Hyzie/IOT_RF/ChipDesign/Schematic.jpg

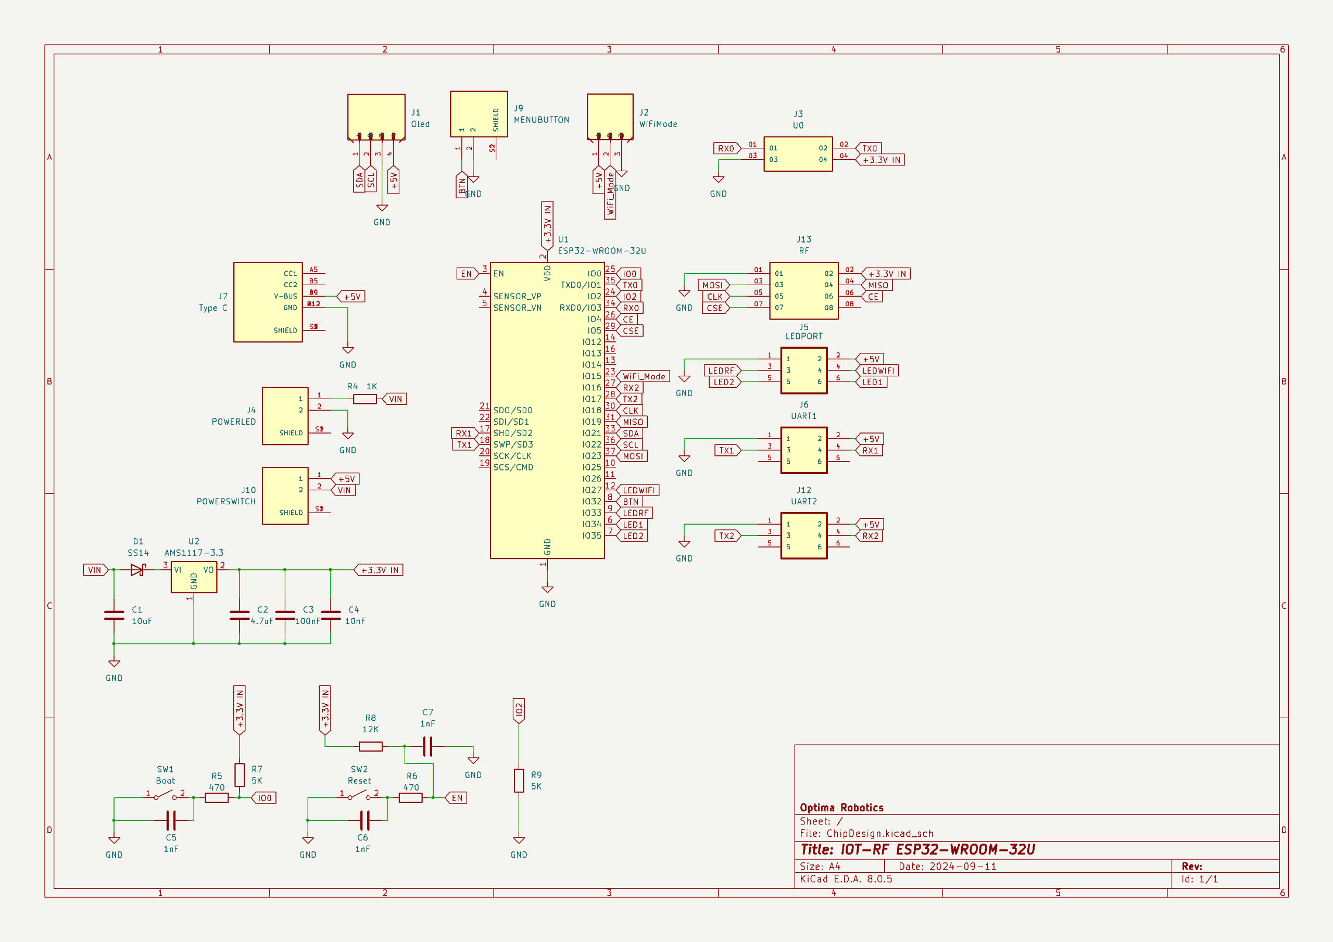
ChipDesign/Schematic.jpg
