Hyzie/IOT_RF/ChipDesign/ChipDesign.step

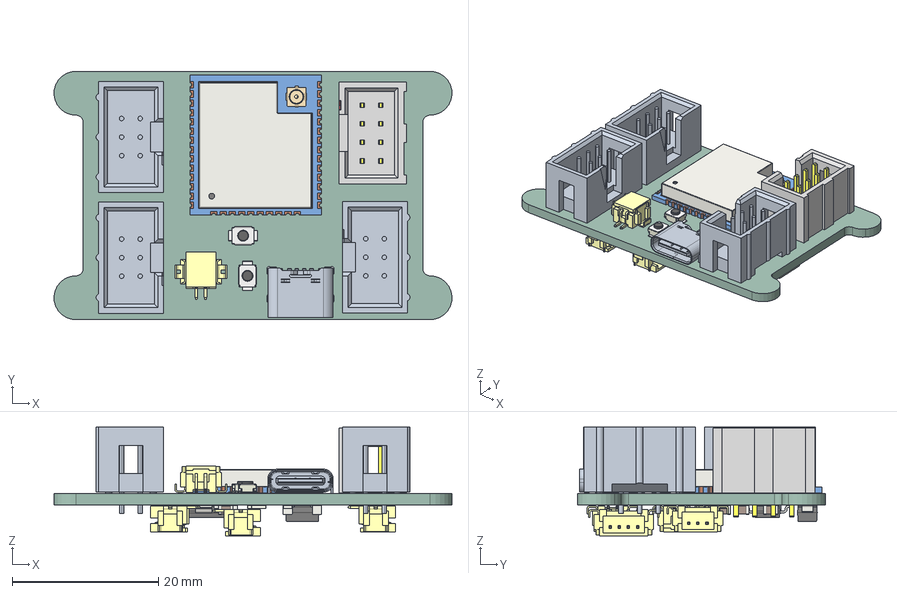
[picture p7: CAD file, 2024-09-18]
ChipDesign/ChipDesign.step
54.5 x 34.0 x 14.9 mm
SW_SPST_B3U-1000P x 2
ESP32-WROOM-32U
TSS-104-01-G-D
DF13A-2P-1.25HÈª x 3
UJC-HP-3-SMT-TR
R_0805_2012Metric x 6
C_0805_2012Metric x 7
D_SMA
SOT_223
DF13A-4P-1.25HÈª
DF13A-3P-1.25HÈª
ChipDesign_PCB
