Hyzie/IOT_RF/ChipDesign/ChipDesign.kicad_pcb

## KiCad design ChipDesign/ChipDesign.kicad_pcb (2024-09-18)

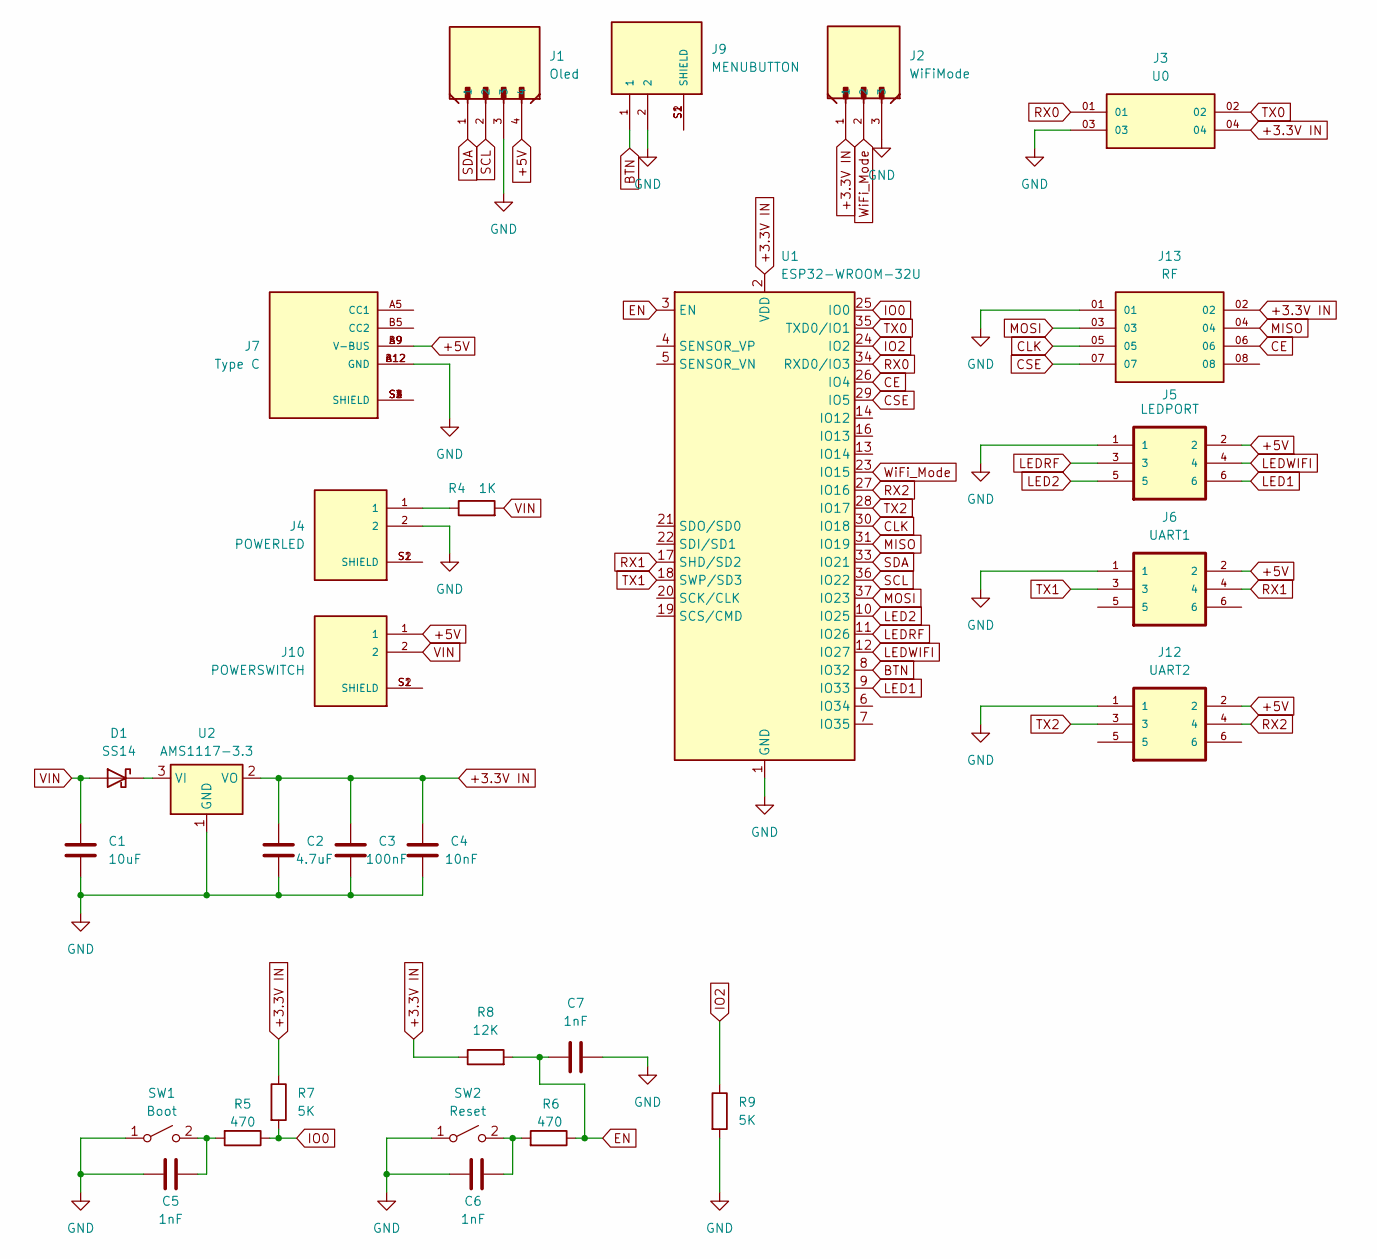
[picture p8: schematic ChipDesign.kicad_sch, IOT-RF ESP32-WROOM-32U]

Parts:
C1: 10uF; C_0805_2012Metric_Pad1.18x1.45mm_HandSolder
C2: 4.7uF; C_0805_2012Metric_Pad1.18x1.45mm_HandSolder
C3: 100nF; C_0805_2012Metric_Pad1.18x1.45mm_HandSolder
C4: 10nF; C_0805_2012Metric_Pad1.18x1.45mm_HandSolder
C5, C6, C7: 1nF; C_0805_2012Metric_Pad1.18x1.45mm_HandSolder
D1: SS14; D_SMA
J1: Oled; HRS_DF13A-4P-1.25H_21_
J2: WiFiMode; HRS_DF13A-3P-1.25H_21_
J3: U0; SAMTEC_RSM-102-02-S-D; PARTREV D
J4: POWERLED; HRS_DF13A-2P-1.25H_51_; PARTREV March 2020
J5: LEDPORT; TE_2-1761603-1; PARTREV B1
J6: UART1; TE_2-1761603-1; PARTREV B1
J7: Type C; CUI_UJC-HP-3-SMT-TR; PARTREV 04/30/2020
J9: MENUBUTTON; HRS_DF13A-2P-1.25H_51_; PARTREV March 2020
J10: POWERSWITCH; HRS_DF13A-2P-1.25H_51_; PARTREV March 2020
J12: UART2; TE_2-1761603-1; PARTREV B1
J13: RF; SAMTEC_TSS-104-01-G-D; PARTREV R
R4: 1K; R_0805_2012Metric_Pad1.20x1.40mm_HandSolder
R5, R6: 470; R_0805_2012Metric_Pad1.20x1.40mm_HandSolder
R7: 5K; R_0805_2012Metric_Pad1.20x1.40mm_HandSolder
R8: 12K; R_0805_2012Metric_Pad1.20x1.40mm_HandSolder
R9: 5K; R_0805_2012Metric
SW1: Boot; SW_Push_SPST_NO_Alps_SKRK
SW2: Reset; SW_Push_SPST_NO_Alps_SKRK
U1: ESP32-WROOM-32U
U2: AMS1117-3.3; SOT-223-3_TabPin2

Connections:
+3.3V IN: C2.1, C3.1, C4.1, J2.1, J3.04, J13.02, R7.1, R8.1, U1.2 (VDD), U2.2 (VO)
+5V: J1.4, J5.2, J6.2, J7.A9 (V-BUS), J7.B9 (V-BUS), J10.1, J12.2
BTN: J9.1, U1.8 (IO32)
CE: J13.06, U1.26 (IO4)
CLK: J13.05, U1.30 (IO18)
CSE: J13.07, U1.29 (IO5)
EN: C7.1, R6.1, R8.2, U1.3 (EN)
GND: C1.2, C2.2, C3.2, C4.2, C5.2, C6.2, C7.2, J1.3, J2.3, J3.03, J4.2, J5.1, J6.1, J7.A12 (GND), J7.B12 (GND), J9.2, J12.1, J13.01, R9.2, SW1.1 (A), SW2.1 (A), U1.1 (GND), U1.15 (GND), U1.38 (GND), U1.39 (GND), U2.1 (GND)
IO0: R5.1, R7.2, U1.25 (IO0)
IO2: R9.1, U1.24 (IO2)
LED1: J5.6, U1.9 (IO33)
LED2: J5.5, U1.10 (IO25)
LEDRF: J5.3, U1.11 (IO26)
LEDWIFI: J5.4, U1.12 (IO27)
MISO: J13.04, U1.31 (IO19)
MOSI: J13.03, U1.37 (IO23)
unnamed: D1.1 (K), U2.3 (VI)
unnamed: J4.1, R4.1
unnamed: J4.S1 (SHIELD), J4.S2 (SHIELD)
unnamed: J7.S1 (SHIELD), J7.S2 (SHIELD), J7.S3 (SHIELD), J7.S4 (SHIELD)
unnamed: J9.S1 (SHIELD), J9.S2 (SHIELD)
unnamed: J10.S1 (SHIELD), J10.S2 (SHIELD)
unnamed: C5.1, R5.2, SW1.2 (B)
unnamed: C6.1, R6.2, SW2.2 (B)
RX0: J3.01, U1.34 (RXD0/IO3)
RX1: J6.4, U1.17 (SHD/SD2)
RX2: J12.4, U1.27 (IO16)
SCL: J1.2, U1.36 (IO22)
SDA: J1.1, U1.33 (IO21)
TX0: J3.02, U1.35 (TXD0/IO1)
TX1: J6.3, U1.18 (SWP/SD3)
TX2: J12.3, U1.28 (IO17)
VIN: C1.1, D1.2 (A), J10.2, R4.2
WiFi_Mode: J2.2, U1.23 (IO15)

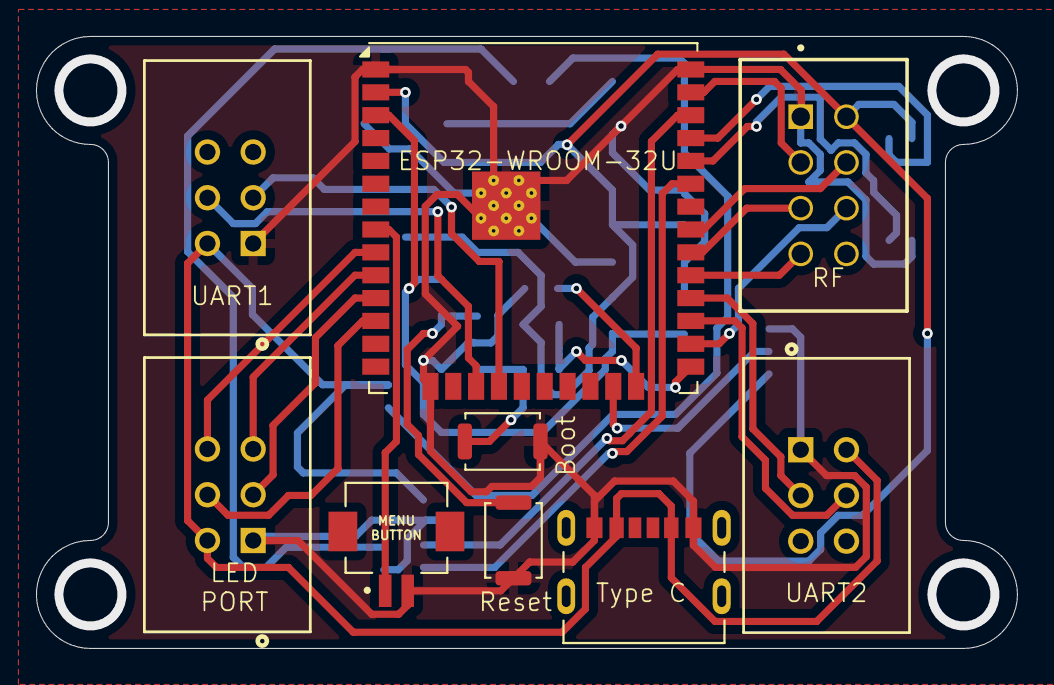
[picture p9: board ChipDesign.kicad_pcb from above]

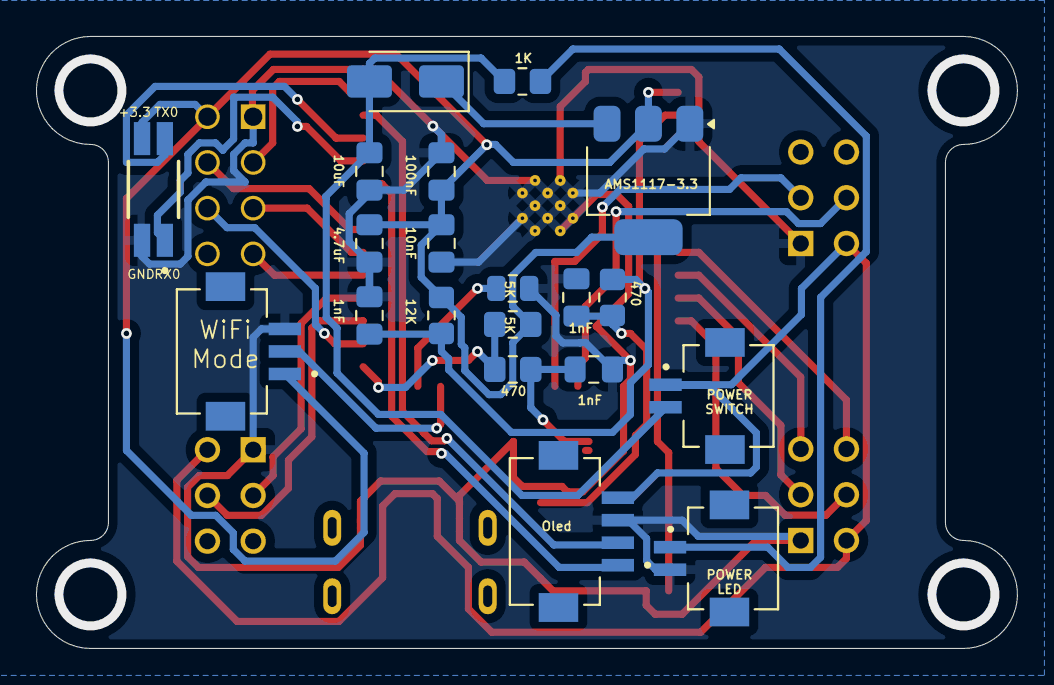
[picture p10: board ChipDesign.kicad_pcb from below]

Board: 2 copper layers, 54.5 x 34.0 mm, 29 parts (20 on the bottom side), 34 nets.
