Hyzie/IOT_RF/TestCode/TestRF/README.md

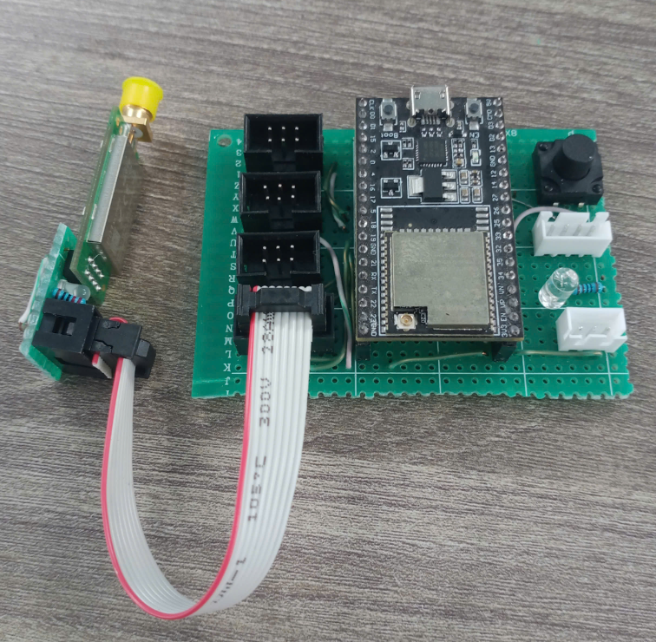
[picture p11: TestCode/TestRF/image.png]
# Bước 1: Nạp code TestTXesp.ino và TestRXesp.ino vào 2 module. Kết nối module RF vào cổng IDC8
# Bước 2: Mở terminal từ 2 module esp32 để quan sát.
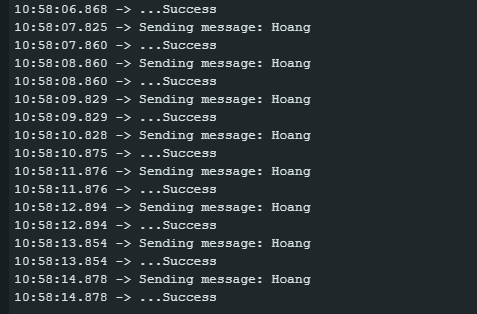
[picture p12: TestCode/TestRF/image-2.png]
## Module TX:
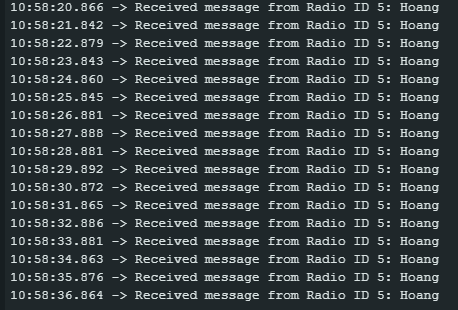
[picture p13: TestCode/TestRF/image-3.png]
## Module RX:
