Hyzie/IOT_RF/TestCode/TestUART/README.md

# Bước 1: Nạp code TestReadUART.ino và TestSendUART.ino cho các module esp32.
# Bước 2: Kết nối UART của 2 module lại với nhau(TX-RX, RX-TX, GND-GND).
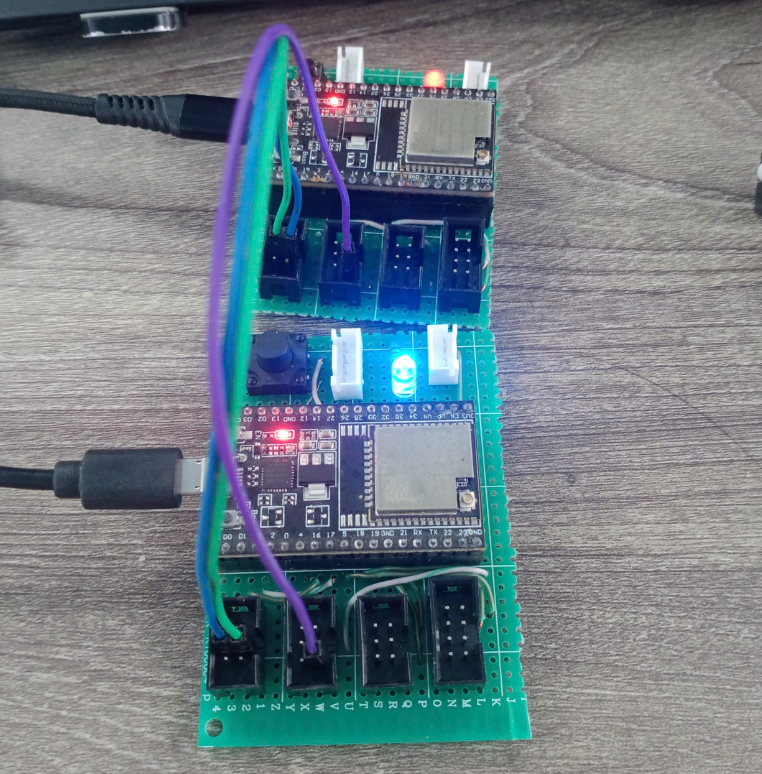
[picture p14: TestCode/TestUART/image.png]

# Bước 3: Mở Terminal để kiểm tra kết quả:
## Terminal:
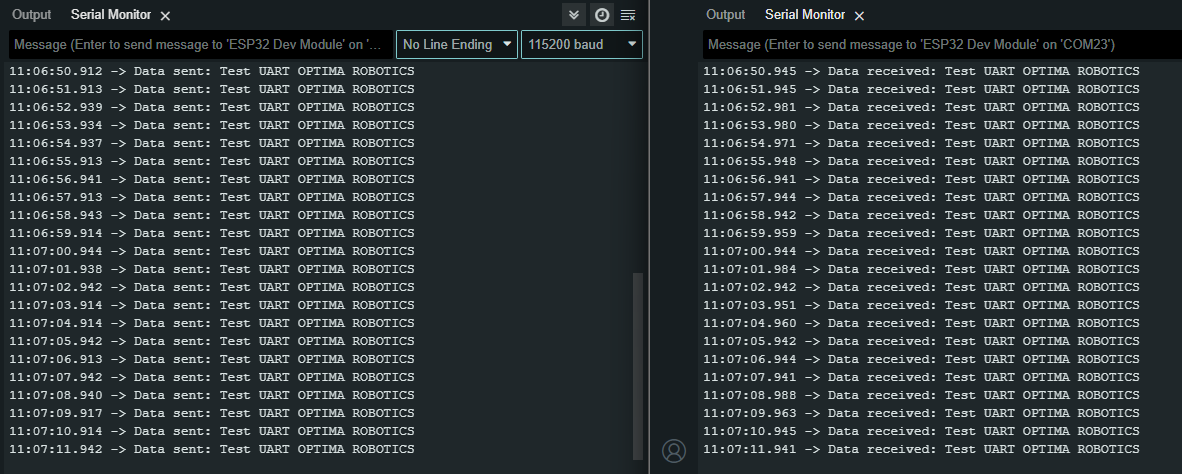
[picture p15: TestCode/TestUART/image-1.png]
