Hyzie/IOT_RF/TestCode/TestRF/image-1.png

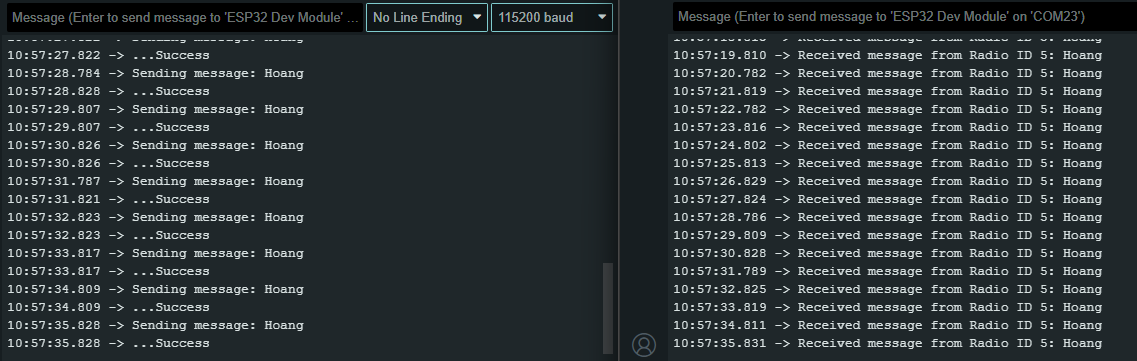
TestCode/TestRF/image-1.png
